gnicolakakis/Robot_Hood/README.md

# Robot_Hood
A quadruped robot used for area protection like a forest or other

Description: Robot Hood is a quadruped programmed area guard, driven by an arduino microcontroller, which achieves movement with the use of servo motors and collects environment data using sensors. The four-legged guard is used to monitor and record the climate of the area, such as temperature, humidity, atmospheric pressure and altitude, and fire signs such as flames and smoke. In addition, there is a camera which detects and recognizes objects in the recorded image, alerting either about a possible fire or possible alterations such as deforestation or possible dumping of rubbish and debris in the area. 
An additional feature is a solar panel which is used to recharge batteries, making the guard autonomous and environmentally friendly. Finally, all sensors data and area images are transmitted and stored in an online database accessible by an authorized user.

Περιγραφή: Το ρομπότ των δασών είναι ένας αυτόνομος τετράποδος φύλακας περιοχής, προγραμματισμένος και κατευθυνόμενος από κύκλωμα Arduino, το οποίο πετυχαίνει κίνηση με την βοήθεια servo motors και "αντιλαμβάνεται" ερεθίσματα με τη βοήθεια αισθητήρων. Το ρομπότ παρακολουθεί κλιματικές αλλαγές στο περιβάλλον που κινείται, καθώς καταγράφει τιμές όπως θερμοκρασία, υγρασία, ατμοσφαιρική πίεση και υψόμετρο και αναγνωρίζει σημάδια πυρκαγιάς όπως φλόγες και καπνό. Επιπλέον, διαθέτει μία κάμερα με τη βοήθεια της οποίας αναγνωρίζει αντικείμενα και κατ'επέκταση πιθανές αλλοιώσεις-διαφοροποιήσεις στην εικόνα που καταγράφει και μεταδίδει, ενημερώνοντας είτε για πιθανή πυρκαγιά είτε για πιθανές αλλοιώσεις όπως αποψιλώσεις ή ρίψη απορριμμάτων και μπαζών στην περιοχή. Ένα επιπλέον χαρακτηριστικό του είναι ότι διαθέτει ένα solar panel με την χρήση του οποίου επαναφορτίζει τις μπαταρίες του, καθιστώντας το φιλικό προς το περιβάλλον. Τέλος, όλες οι τιμές των μετρήσεων από τους αισθητήρες καθώς και εικόνες από την αναγνώριση της περιοχής, μεταδίδονται και αποθηκεύονται online στο διαδίκτυο σε τοποθεσία που έχει πρόσβαση εξουσιοδοτημένος χρήστης.

Βίντεο επίδειξης Robot Hood :https://mega.nz/file/hQUAxKbQ#NrwdcVnC_BHzOpZGOr8vxtHDjy6ADQ8zAvQJZpFa-Zo

List of recommended equipment

x1 arduino (uno/mega)
x11 mg996r servo motors 
x16 κομμάτια plexi glass/plastic for skeleton 
x1 camera (+ module for this camera) 
x1 ESP32 camera + wifi module 
x1 ESP8266 NodeMcu 
x1 DHT11 temperature and humidity sensor
x1 BMP280 barometric pressure sensor
x1 MQ2 gas sensor
x1 supersonic sensor
x1 solar panel 
x1 lithium battery (6v-7.2v)

Ενδεικτικό κόστος κατασκευής περίπου 150-180 Ευρώ
