gnicolakakis/Robot_Hood/Robot Hood_Instructions.pdf

## Το Ρομπότ των Δασών – Robot Hood

### Τετράποδος «δασοφύλακας» βασισμένος σε νευρωνικό δίκτυο

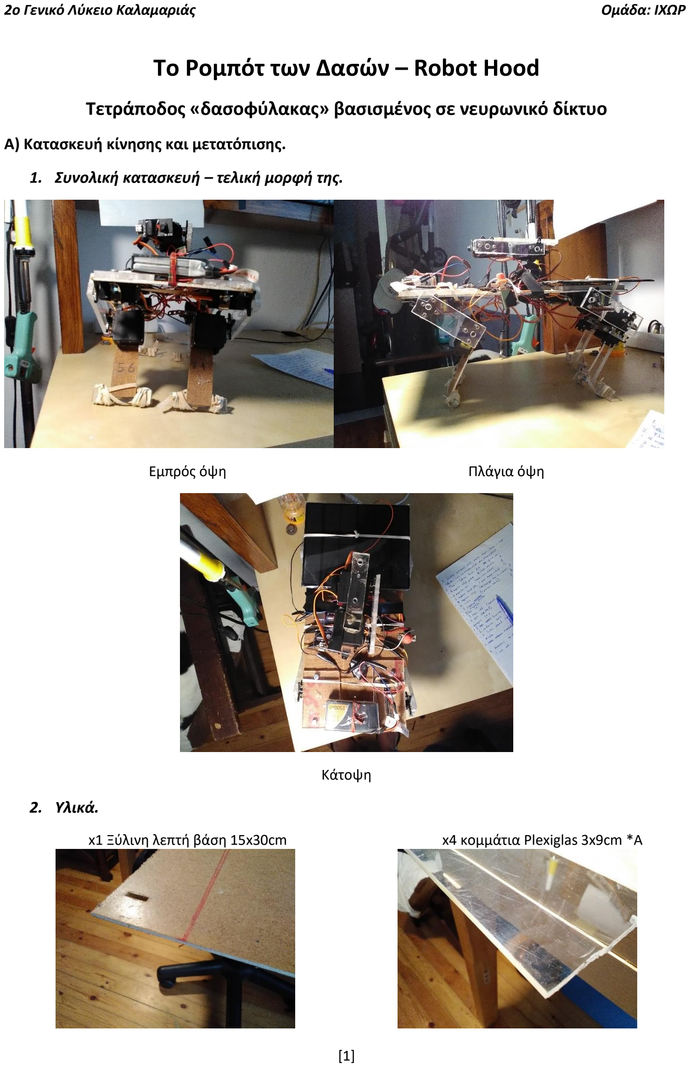
[picture p1: page 1]

2o Γενικό Λύκειο Καλαμαριάς | Ομάδα: ΙΧΩΡ

Α) Κατασκευή κίνησης και μετατόπισης.

1. Συνολική κατασκευή – τελική μορφή της.
Εμπρός όψη | Πλάγια όψη

Κάτοψη

2. Υλικά.
x1 Ξύλινη λεπτή βάση 15x30cm | x4 κομμάτια Plexiglas 3x9cm *A

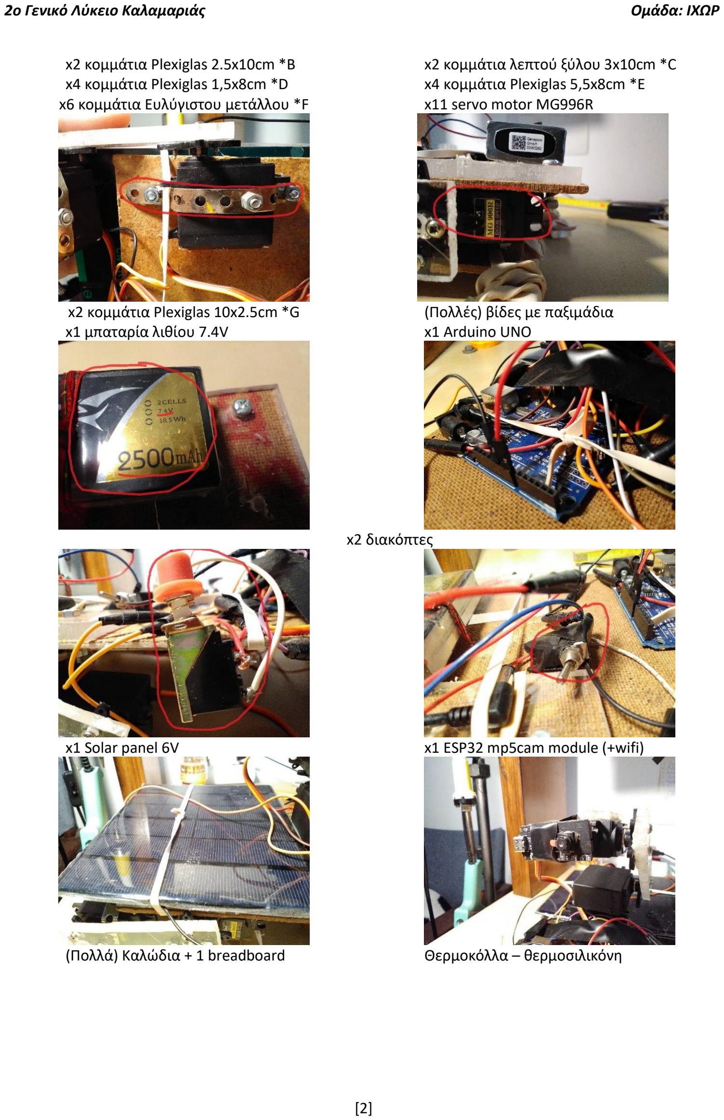
[picture p2: page 2]

x2 κομμάτια Plexiglas 2.5x10cm *B | x2 κομμάτια λεπτού ξύλου 3x10cm *C
x4 κομμάτια Plexiglas 1,5x8cm *D | x4 κομμάτια Plexiglas 5,5x8cm *E
x6 κομμάτια Ευλύγιστου μετάλλου *F | x11 servo motor MG996R
x2 κομμάτια Plexiglas 10x2.5cm *G | (Πολλές) βίδες με παξιμάδια
x1 μπαταρία λιθίου 7.4V | x1 Arduino UNO

x2 διακόπτες

x1 Solar panel 6V | x1 ESP32 mp5cam module (+wifi)
(Πολλά) Καλώδια + 1 breadboard | Θερμοκόλλα – θερμοσιλικόνη

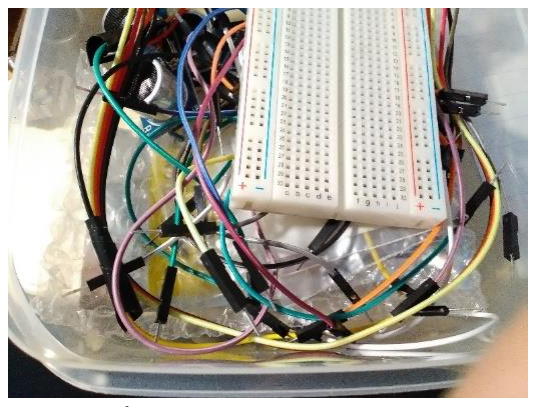
[picture p3: figure]
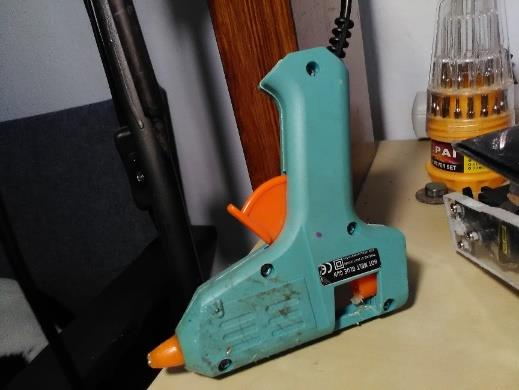
[picture p4: figure]

Λαστιχάκια

3. Κατασκευή ποδιών.

Μπροστά πόδια:

Α) Στο κομμάτι Α κάνουμε 2 τρύπες (6mm) που απέχουν 6 όπως στην εικόνα1:

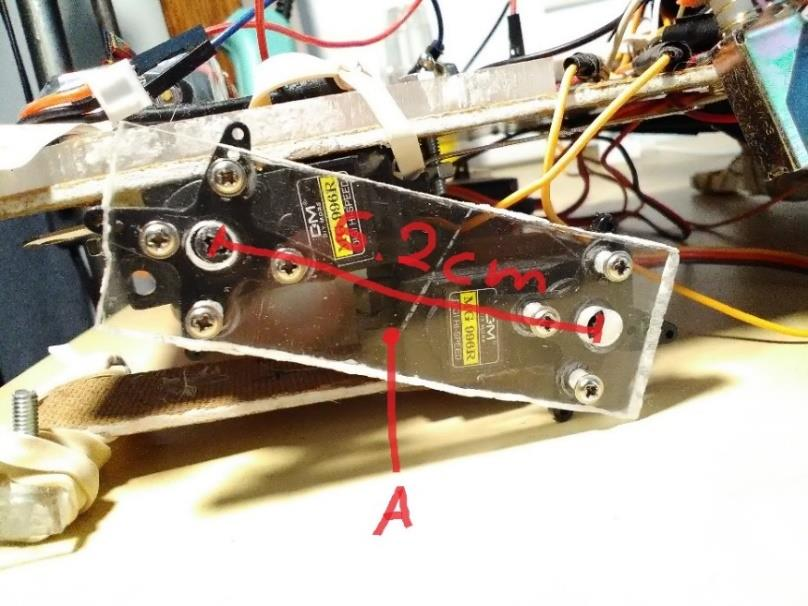
[picture p5: figure]

Εικόνα 1

Β) Βιδώνουμε τα Servo στα πλάγια όπως φαίνεται στην εικόνα 2:

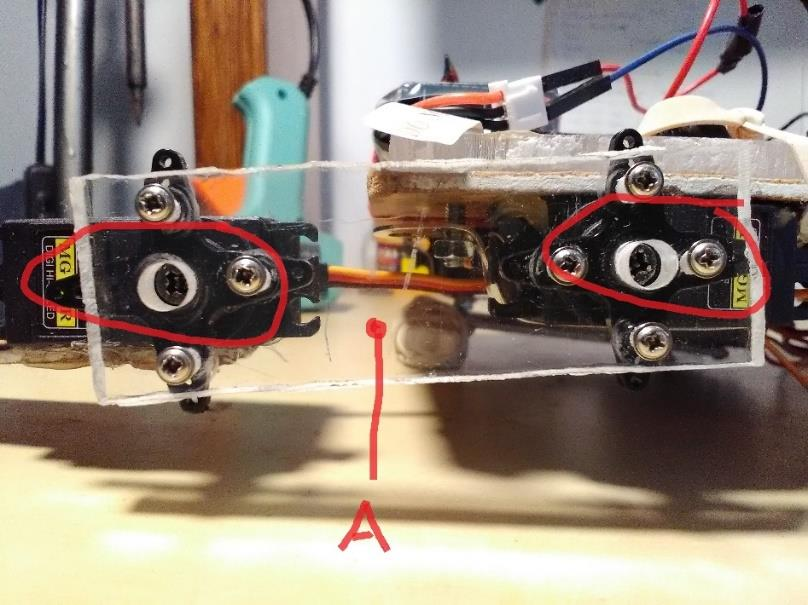
[picture p6: figure]

Εικόνα 2

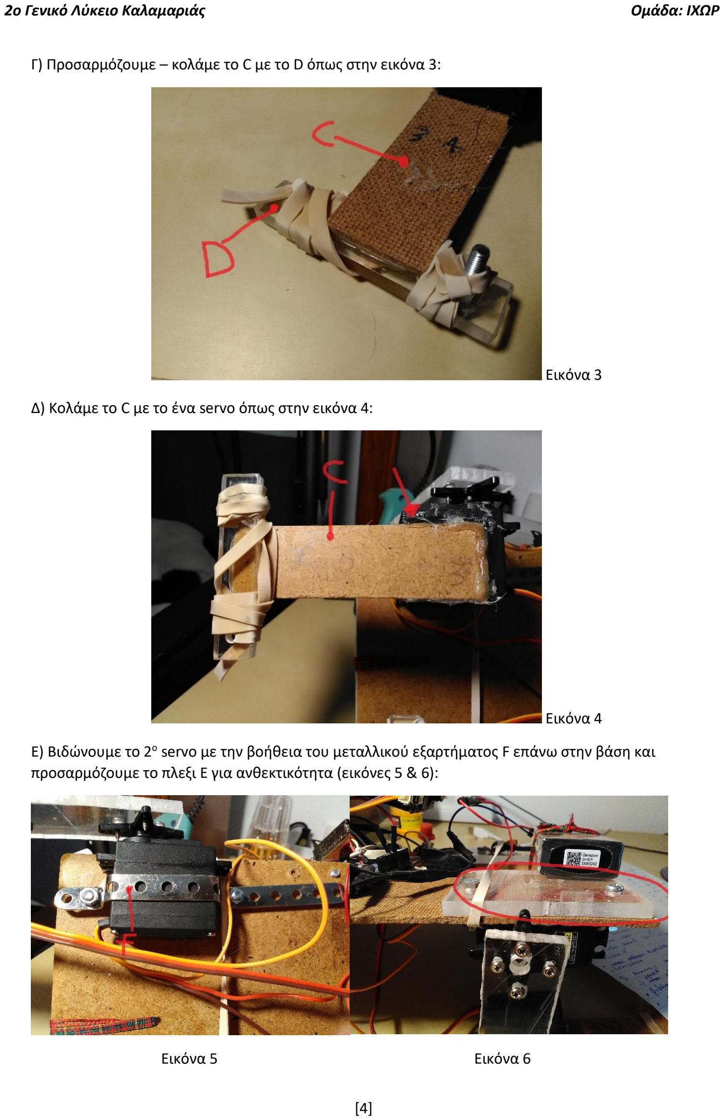
[picture p7: page 4]

Γ) Προσαρμόζουμε – κολάμε το C με το D όπως στην εικόνα 3:

Εικόνα 3

Δ) Κολάμε το C με το ένα servo όπως στην εικόνα 4:

Εικόνα 4

Ε) Βιδώνουμε το 2ο
servo με την βοήθεια του μεταλλικού εξαρτήματος F επάνω στην βάση και προσαρμόζουμε το πλεξι E για ανθεκτικότητα (εικόνες 5 & 6):
Εικόνα 5 | Εικόνα 6

Πίσω πόδια:

Το ίδιο και για τα πίσω, απλώς προσαρμόζουμε αντί για το C (ξύλο) στην θέση του βάζουμε το B (Plexiglas) όπως στην εικόνα 7:

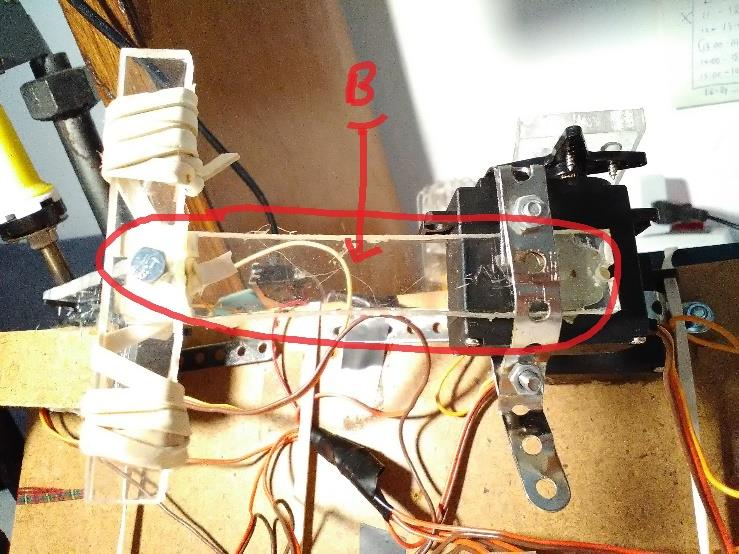
[picture p8: figure]

Εικόνα 7

Συνολικά:

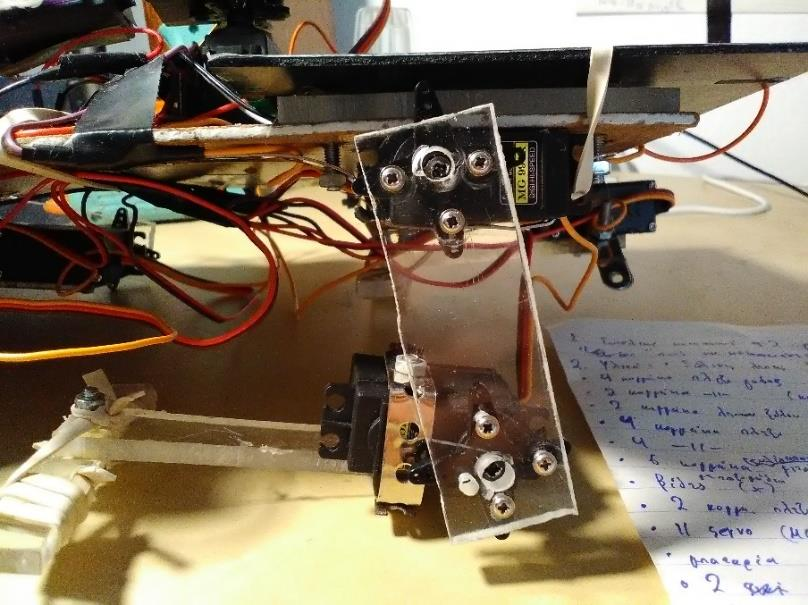
[picture p9: figure]

Εικόνα 8

Έτσι, βιδώνουμε όλα τα πόδια επάνω στην βάση, απλώς προσέχουμε τα αριστέρα servo να είναι εφαρμοσμένα σε αντίθετες πλευρές από τα δεξιά επάνω στην βάση, διότι τα servo έχουν δυνατή περιστροφή έως 180ο
. Το κάτω μέρος της τελικής κατασκευής φαίνεται στην εικόνα 9:

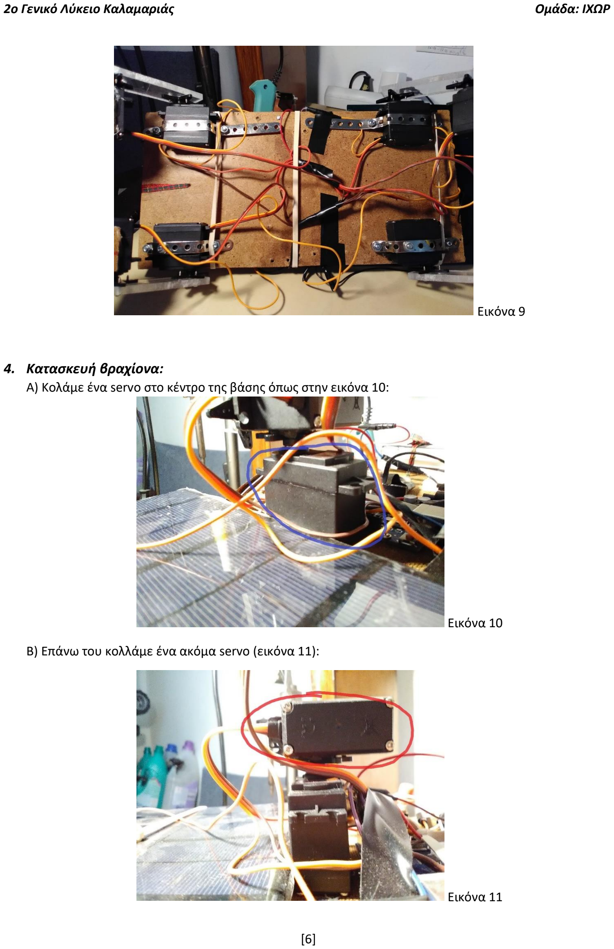
[picture p10: page 6]

Εικόνα 9

### 4. Κατασκευή βραχίονα:

Α) Κολάμε ένα servo στο κέντρο της βάσης όπως στην εικόνα 10:

Εικόνα 10

Β) Επάνω του κολλάμε ένα ακόμα servo (εικόνα 11):

Εικόνα 11

Γ) στο κομμάτι G (plexiglas) κάνουμε 2 τρύπες (6mm) απόστασης 7cm και βιδώνουμε 2 servo, όπως στην εικόνα 12:

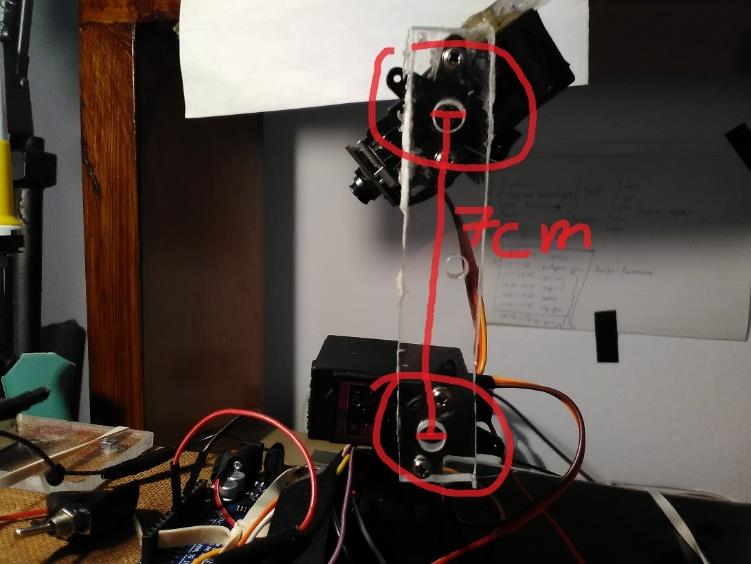
[picture p11: figure]

Εικόνα 12

Δ) Στην επιφάνεια του servo στην κορυφή, κολάμε το 2ο κομμάτι G (plexi glas) όπως στην εικόνα 13:

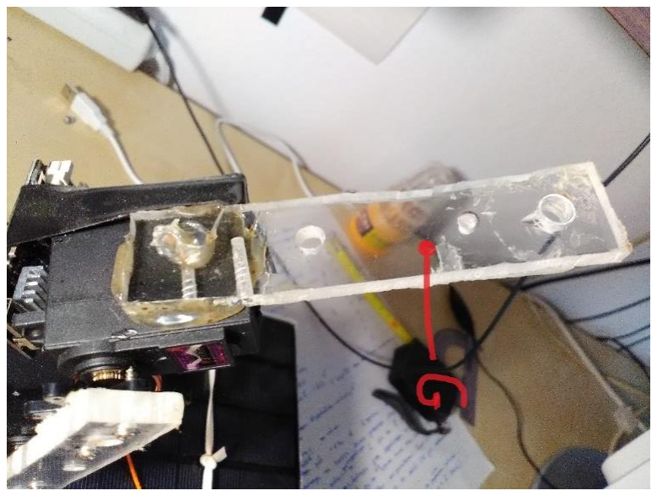
[picture p12: figure]

Εικόνα 13

Ε) Στην αντίθετη πλευρά του servo στην κορυφή στερεώνουμε την κάμερα f (εικόνα 14)

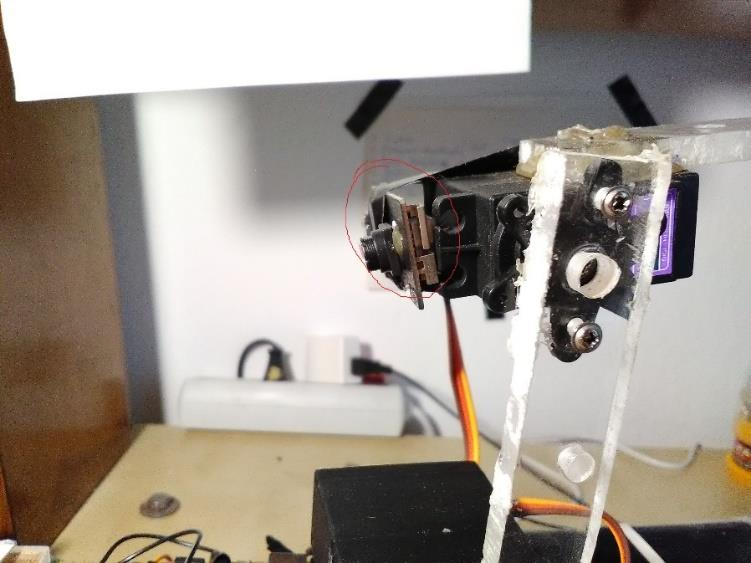
[picture p13: figure]

Εικόνα 14

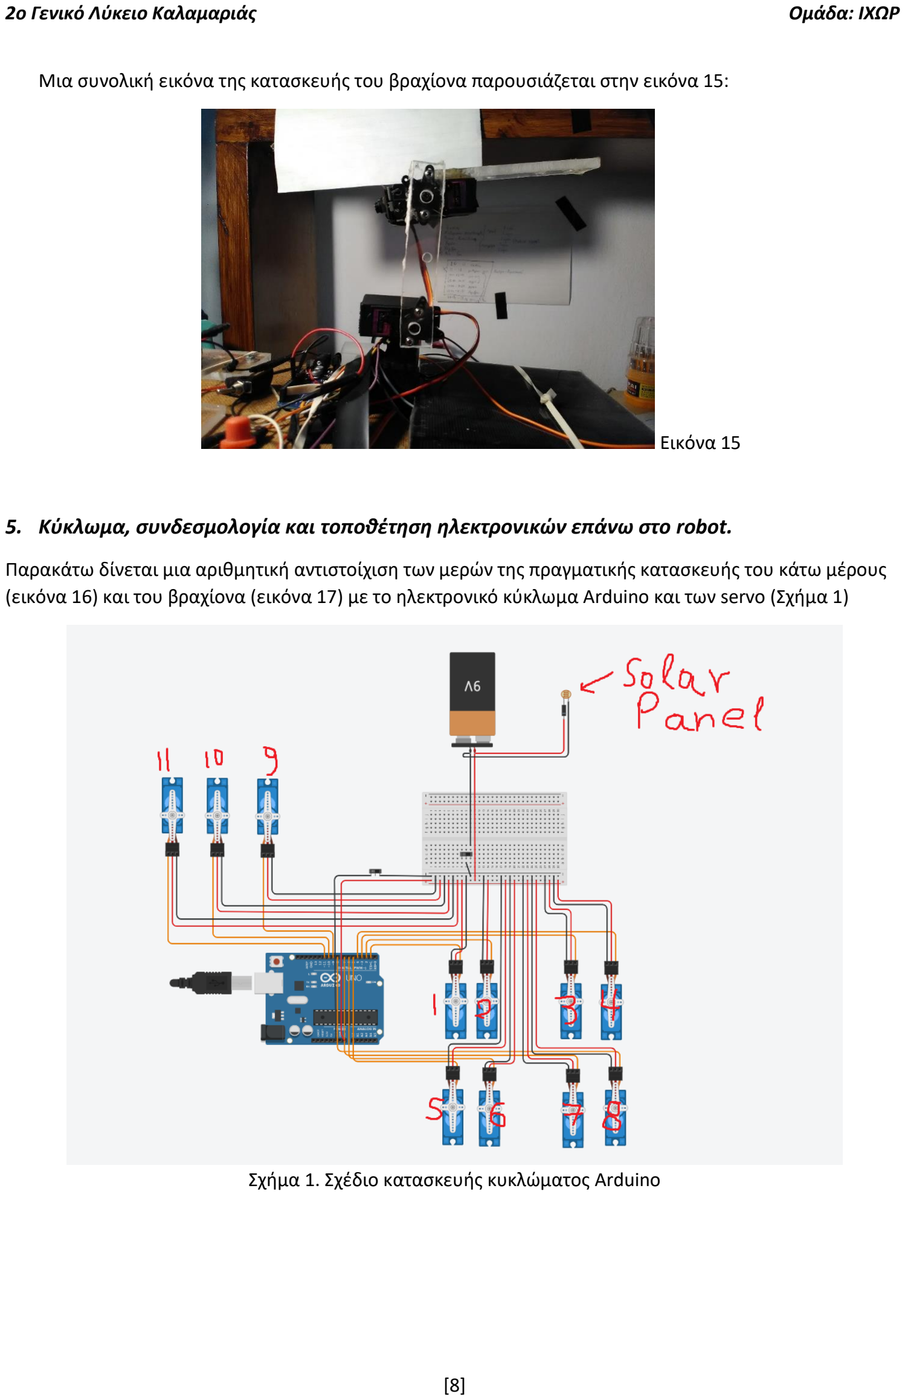
[picture p14: page 8]

Μια συνολική εικόνα της κατασκευής του βραχίονα παρουσιάζεται στην εικόνα 15:

Εικόνα 15

5. Κύκλωμα, συνδεσμολογία και τοποθέτηση ηλεκτρονικών επάνω στο robot.

Παρακάτω δίνεται μια αριθμητική αντιστοίχιση των μερών της πραγματικής κατασκευής του κάτω μέρους (εικόνα 16) και του βραχίονα (εικόνα 17) με το ηλεκτρονικό κύκλωμα Arduino και των servo (Σχήμα 1)

Σχήμα 1. Σχέδιο κατασκευής κυκλώματος Arduino

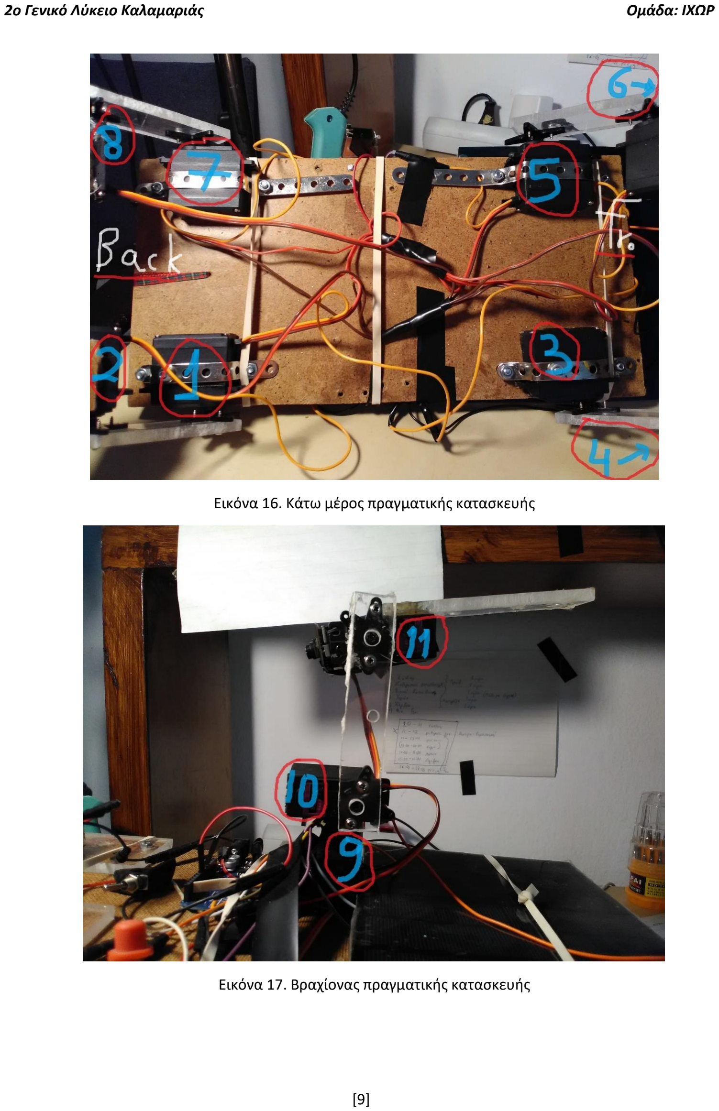
[picture p15: page 9]

Εικόνα 16. Κάτω μέρος πραγματικής κατασκευής

Εικόνα 17. Βραχίονας πραγματικής κατασκευής

Τοποθέτηση ηλεκτρονικών στοιχείων στο επάνω μέρος στο robot.

Α) Περίπου στο κέντρο της βάσης βιδώνουμε το Arduino (εικόνα 18):

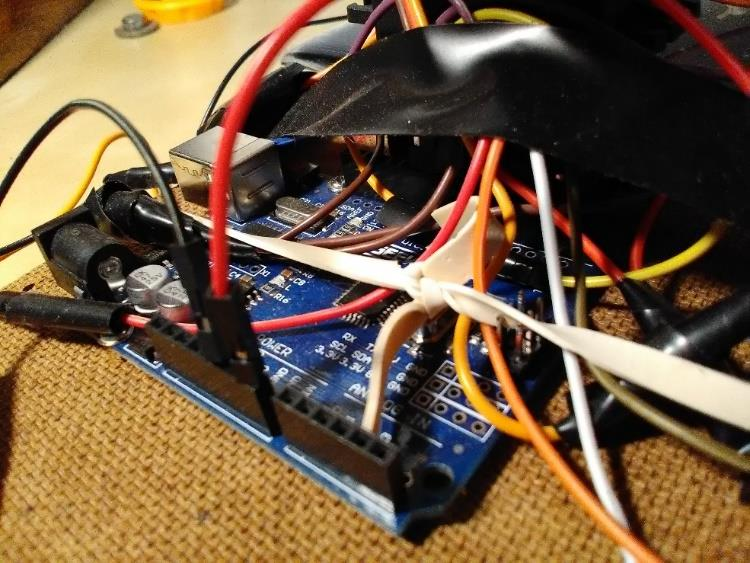
[picture p16: figure]

Εικόνα 18

Β) Στο πίσω μέρος το Solar panel (εικόνα 19):

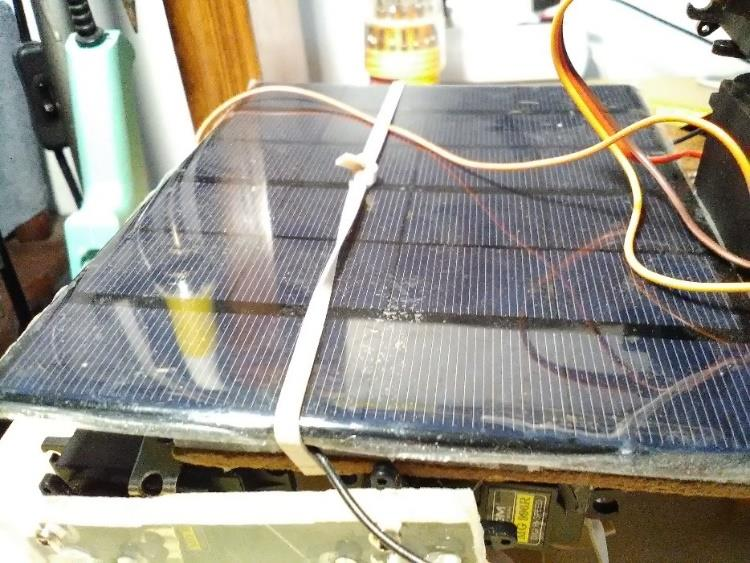
[picture p17: figure]

Εικόνα 19

Γ) Μπροστά την μπαταρία και τους διακόπτες (εικόνα 20):

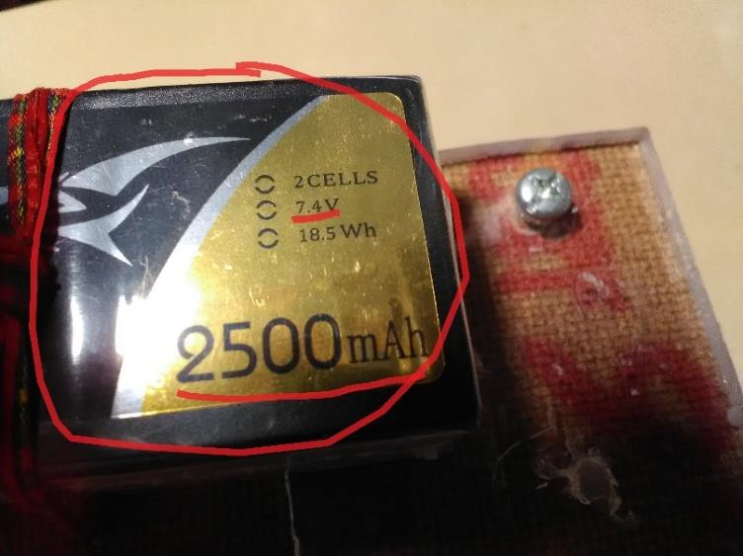
[picture p18: figure]

Εικόνα 20

### 6. Ρύθμιση Servo στις σωστές μοίρες – θέσεις – Calibration

Α) Ξεβιδώνουμε όλα τα πλαϊνά μέρη Plexiglas των ποδιών και του βραχίονα

Β) Ορίζουμε στον κώδικα του Arduino ΟΛΑ τα servo από το 1 έως το 11 να έρθουν στις 90ο
servoX.write(90);

Γ) Ξαναβιδώνουμε όλα τα Plexiglas των ποδιών και του βραχίονα σε αυτές τις θέσεις χωρίς να περιστρέφουμε τα servo.

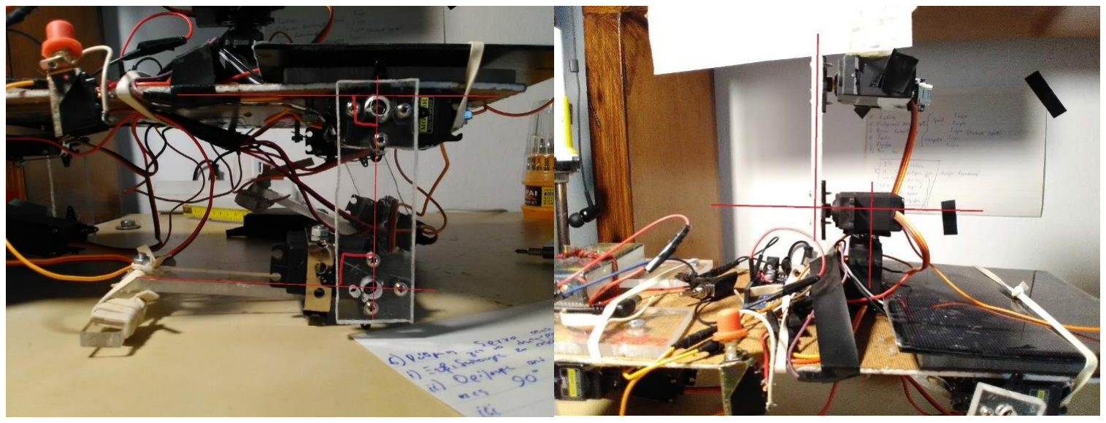
[picture p19: figure]

Εικόνα 21 | Εικόνα 22

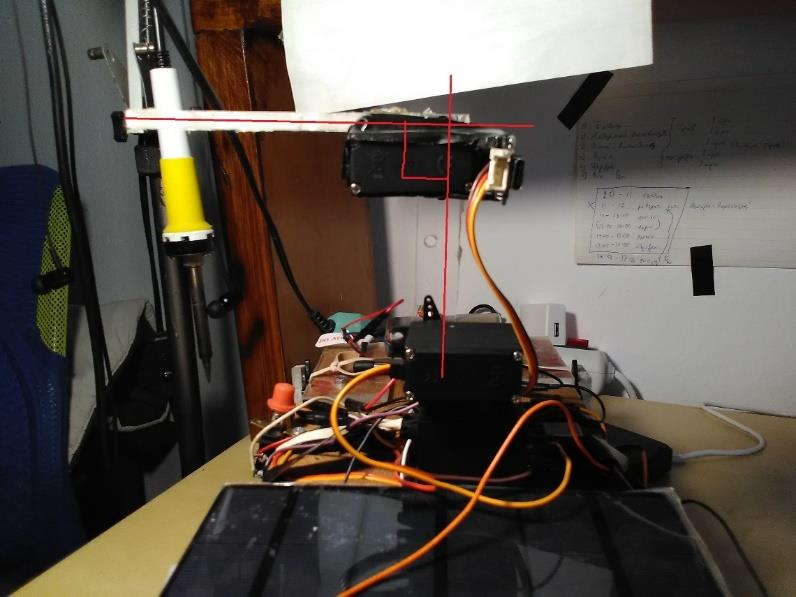
[picture p20: figure]

Εικόνα 23

### 7. Κώδικας

Α) Arduino – κίνηση

Μέσα στον κώδικα του Arduino έχουν αναπτυχθεί κάποιοι διαδικασιακοί αλγόριθμοι για την κίνηση του robot.

Συγκεκριμένα:

- Calibration – επαναφορά του robot στην «όρθια κατάσταση».

- Arm_right/Arm_left - Επαναφορά του robot μετά από ανατροπή, στην δεξιά ή αριστερή του πλευρά, με την βοήθεια του βραχίονα.
- Βάδισμα.
- Επιτόπου βάδισμα.
- Στροφή δεξιά/αριστερά.
- Να ξαπλώνει/μαζεύει τα πόδια του σε κατάσταση «ξεκούρασης» εξοικονόμησης ενέργειας.
- Να ανατρέπει το σώμα του δεξιά/αριστερά – να «πέφτει».

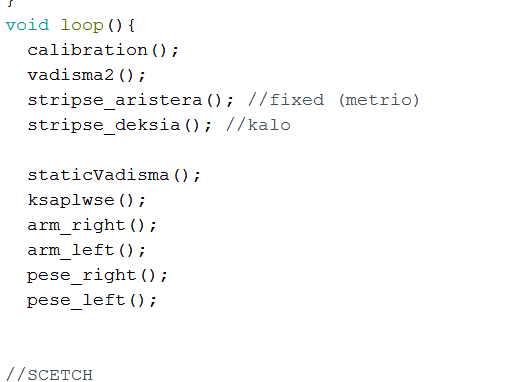
[picture p21: figure]

Β) Αναγνώριση αντικειμένων – νευρωνικό δίκτυο – οδηγίες χρήσης.

Για την αναγνώριση των αντικειμένων όπως φωτιά και αντικείμενα εμπρησμού όπως αναπτήρας, μπιτόνι βενζίνης, καπνός, μπάζα, απορρίμματα, άγρια ή σπάνια είδη ζώων, το robot χρησιμοποιεί νευρωνικό δίκτυο – «τεχνητή νοημοσύνη» και συγκεκριμένα το yolo9000 object detection (You Only Look Once). Είναι ανοιχτού κώδικα και υπάρχει στο github.

Οδηγίες και μία ματιά στον κώδικα.

i) Συνδέουμε μία 2η
κάρτα δικτύου στον υπολογιστή μας (εικόνα 24):

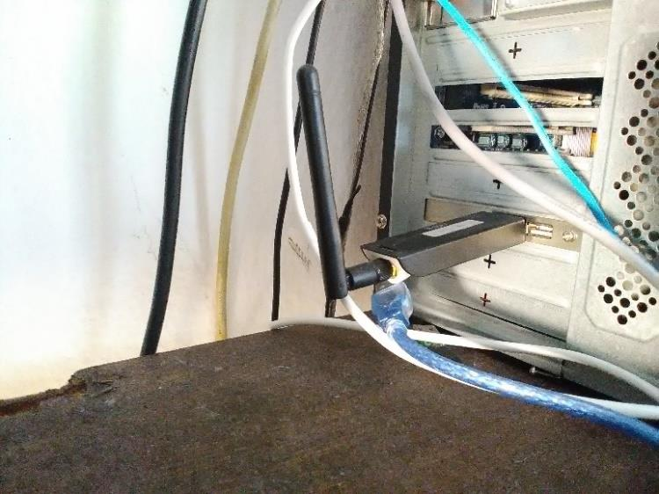
[picture p22: figure]

Εικόνα 24

ii) Ενεργοποιούμε την κάμερα του robot και από την 2η κάρτα δικτύου συνδεόμαστε στο σημείο πρόσβασης wifi που έχει δημιουργήσει η κάμερα (εικόνες 25-26):

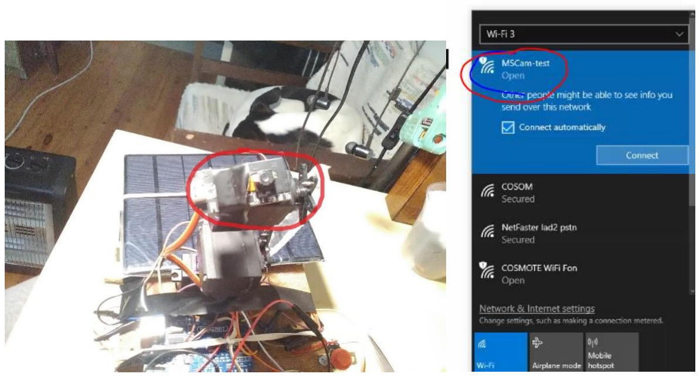
[picture p23: figure]

Εικόνες 25&26

iii) Συγχρονίζουμε έναν άδειο φάκελο του υπολογιστή μας με το Google Drive Sync app και μέσα στον φάκελο ρίχνουμε το αρχείο imgkit.py (εικόνες 27):

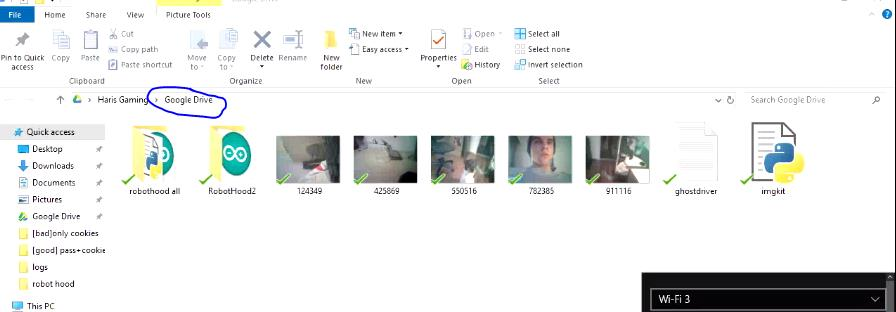
[picture p24: figure]

Εικόνα 27

iv) Τρέχουμε το imgkit.py και βεβαιωνόμαστε ότι η 1η
κάρτα δικτύου έχει πρόσβαση στο διαδίκτυο. Εάν πραγματοποιηθούν σωστά τα παραπάνω βήματα, κάθε 5 δευτερόλεπτα θα εμφανίζονται φωτογραφίες από την κάμερα του robot στον φάκελο όπου με την σειρά τους συγχρονίζονται στο Google Drive μας.

Το πρόγραμμα imgkit.py βρίσκεται ελεύθερο προς χρήση στο GitHub

https://github.com/gnicolakakis/Robot_Hood/blob/master/imgkit.py

v) Ανοίγουμε στο Google Colab το script Objectdetection2.ipynb και το τρέχουμε.

Θα ζητηθεί είσοδος (sign in) στο Google Drive και μόλις ολοκληρωθεί, θα έχει ήδη ξεκινήσει η αναγνώριση των φωτογραφιών για αντικείμενα από το Google Drive που στέλνει η κάμερα του robot.

Συγκεκριμένα είναι δυνατή η αναγνώριση 9000 αντικειμένων. Μπορείτε να τα βρείτε εδώ: https://github.com/pjreddie/darknet/blob/1e729804f61c8627eb257fba8b83f74e04945db7/data/9k.names

Τέλος, μπορούμε μετά από κάθε επανάληψη του κώδικα στο Google Colab, να βλέπουμε τα αποτελέσματα της αναγνώρισης στο αρχείο results.json.

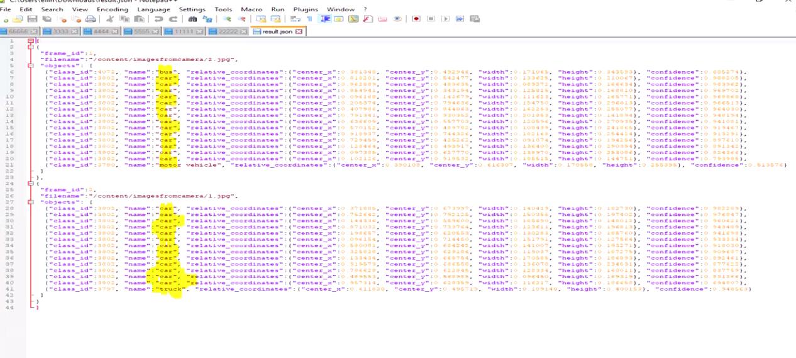
[picture p25: figure]

Εικόνα 28

Ως αποτελέσματα εμφανίζονται, το όνομα της φωτογραφίας, τα ονόματα των αντικειμένων που εντοπίστηκαν και το ποσοστό της πιθανότητας (πχ στο παραπάνω παράδειγμα στην εικόνα 28 αναγνωρίστηκε ένα αυτοκίνητο με πιθανότητα 90% - car 90%) όπως και οι συντεταγμένες του κάθε αντικειμένου επάνω στην εικόνα.

Γ) Κύκλωμα μέτρησης θερμοκρασίας, υγρασίας, βαρομετρικής πίεσης και ανίχνευσης καπνού

Στο σχήμα 2 δίνεται η συνδεσμολογία του κυκλώματος. Το κύκλωμα λειτουργεί αυτόνομα και προστίθεται πάνω στην κατασκευή.

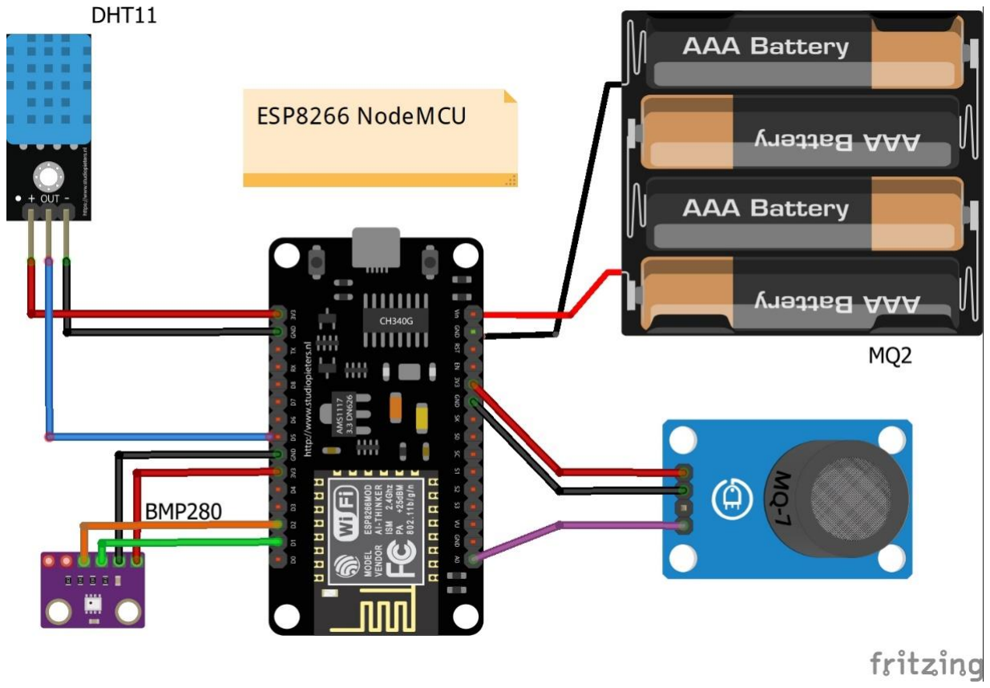
[picture p26: figure]

Σχήμα 2. Συνδεσμολογία κυκλώματος μέτρησης θερμοκρασίας, υγρασίας, πίεσης και αερίων

Υλικά του κυκλώματος

- x1 μικροελεγκτής ESP8266 NodeMCU
- x1 αισθητήρας θερμοκρασίας και υγρασίας DHT 11
- x1 αισθητήρας βαρομετρικής πίεσης BMP280
- x1 αισθητήρας καπνού, τοξικών και εκρηκτικών αερίων MQ2
- x1 μπαταριοθήκη 4xAAA
- x4 μπαταρίες 1,5V AAA
- καλώδια σύνδεσης θηλυκό σε θηλυκό

Λειτουργία του κυκλώματος

Οι αισθητήρες συλλέγουν τα δεδομένα από το περιβάλλον και τα μεταδίδουν στον μικροελεγκτή ESP8266. Αυτός με τη σειρά του τα μετατρέπει σε μορφή HTML και τα μεταδίδει μέσω WiFi σε συγκεκριμένη IP Web address, όπου και εμφανίζονται στην οθόνη (εικόνα 29). Η ανανέωση των δεδομένων γίνεται κάθε φορά που ο χρήστης ανανεώνει τη σελίδα. H IP της σελίδας ορίζεται από τον κώδικα, αφού οριστεί το username και το password ενός τοπικού WiFi.

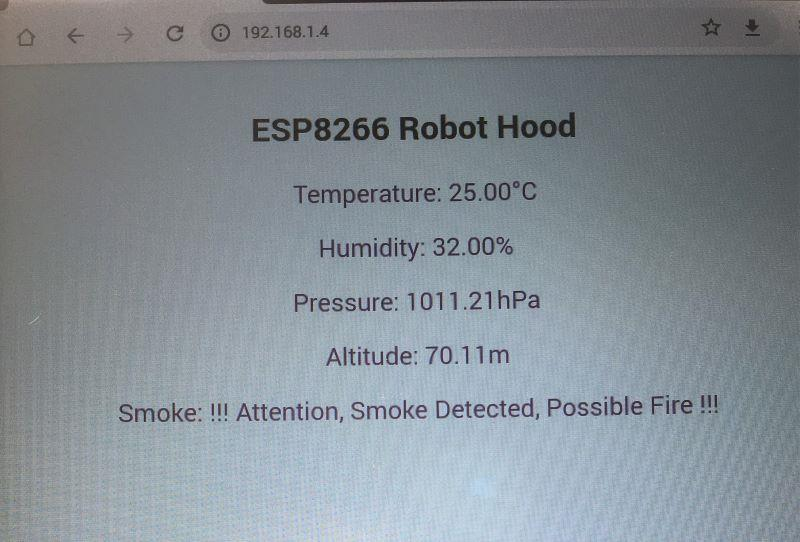
[picture p27: figure]

Εικόνα 29

Το πρόγραμμα που περιέχει τον κώδικα βρίσκεται ελεύθερο προς χρήση στο GitHub https://github.com/gnicolakakis/Robot_Hood/blob/master/robot_hood_sensors.ino

Δ) Κοστολόγιο υλικών

Είδος | Ποσότητα | Κόστος σε €
Ξύλινη λεπτή βάση | 1 | 1
PlexiGlass | 16 | 4
Εύκαμπτοι μεταλλικοί σύνδεσμοι | 6 | 2
Διακόπτες | 2 | 1
Arduino Uno | 1 | 20
ESP8266 | 1 | 7
Servo motor MG996R | 11 | 70
Ultrasonic sensor | 2 | 4
ESP32 mp5cam module (+wifi) | 1 | 21
Μπαταρία λιθίου 7.4V | 1 | 18
Solar panel 6V | 1 | 8

Ασύρματη κάρτα δικτύου | 1 | 10
DHT11 temperature sensor | 1 | 2
BMP280 barometric pressure sensor | 1 | 4
MQ2 gas sensor | 1 | 4
Θήκη μπαταριών 4xAAA | 1 | 1,5
Μπαταρία 1,5V AAA | 4 | 2
Breadboard | 1 | 2
Καλώδια | 60-70 | 2
Θερμοκόλλα – θερμοσιλικόνη σε στικ | 4 | 0,4
Λαστιχάκια | 10 | 0,1
Βίδες | 50 | 1
Σύνολο | | 185
